AnianBrosig/powerPCB/PowerDistrobution2L/PowerDistrobution2L.step

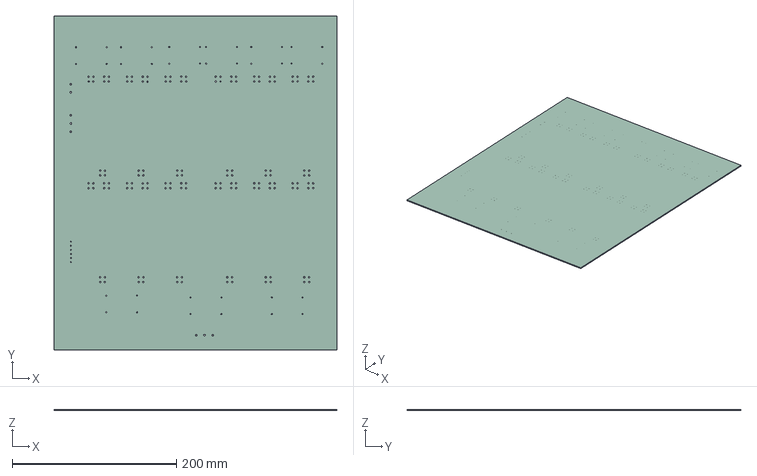
[picture p1: CAD file, 2025-11-11]
PowerDistrobution2L/PowerDistrobution2L.step
345.0 x 407.0 x 1.51 mm
