AnianBrosig/powerPCB/PowerDistribution3L/PowerDistrobution3L.kicad_pcb

## KiCad design PowerDistribution3L/PowerDistrobution3L.kicad_pcb (2025-11-13)

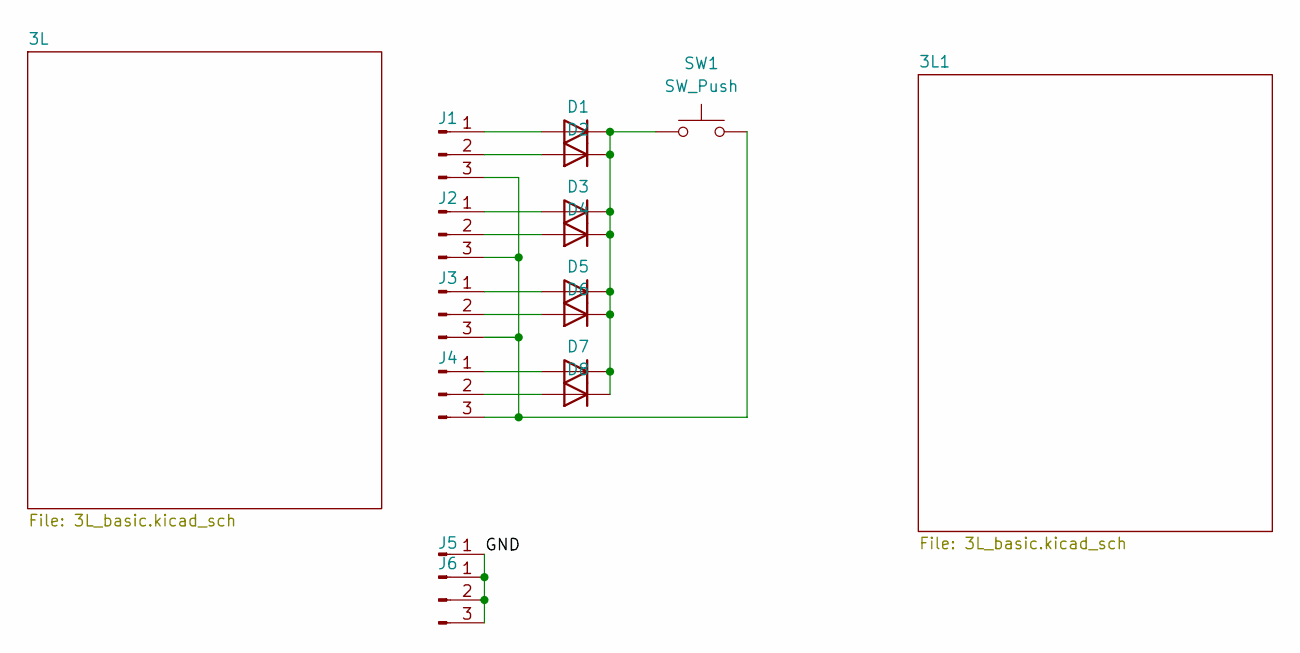
[picture p2: schematic PowerDistrobution3L.kicad_sch]

Parts:
D1, D2, D3, D4, D5, D6, D7, D8: 1N914; D_DO-35_SOD27_P7.62mm_Horizontal
J1, J3, J4, J6: Conn_01x03_Pin; PinHeader_1x03_P2.54mm_Vertical
J2: Connector_PinHeader_1.00mm:PinHeader_1x03_P1.00mm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; PinHeader_1x03_P2.54mm_Vertical
J5: Conn_01x01_Pin; Wuerth_REDCUBE-THR_WP-THRSH_74651175_THR
SW1: SW_Push; SW_PUSH_6mm

Connections:
/GND: J5.1, J6.1, J6.2, J6.3
unnamed: D1.2 (A), J1.1
unnamed: D1.1 (K), D2.1 (K), D3.1 (K), D4.1 (K), D5.1 (K), D6.1 (K), D7.1 (K), D8.1 (K), SW1.1
unnamed: D2.2 (A), J1.2
unnamed: D3.2 (A), J2.1
unnamed: D4.2 (A), J2.2
unnamed: D5.2 (A), J3.1
unnamed: D6.2 (A), J3.2
unnamed: D7.2 (A), J4.1
unnamed: D8.2 (A), J4.2
unnamed: J1.3, J2.3, J3.3, J4.3, SW1.2

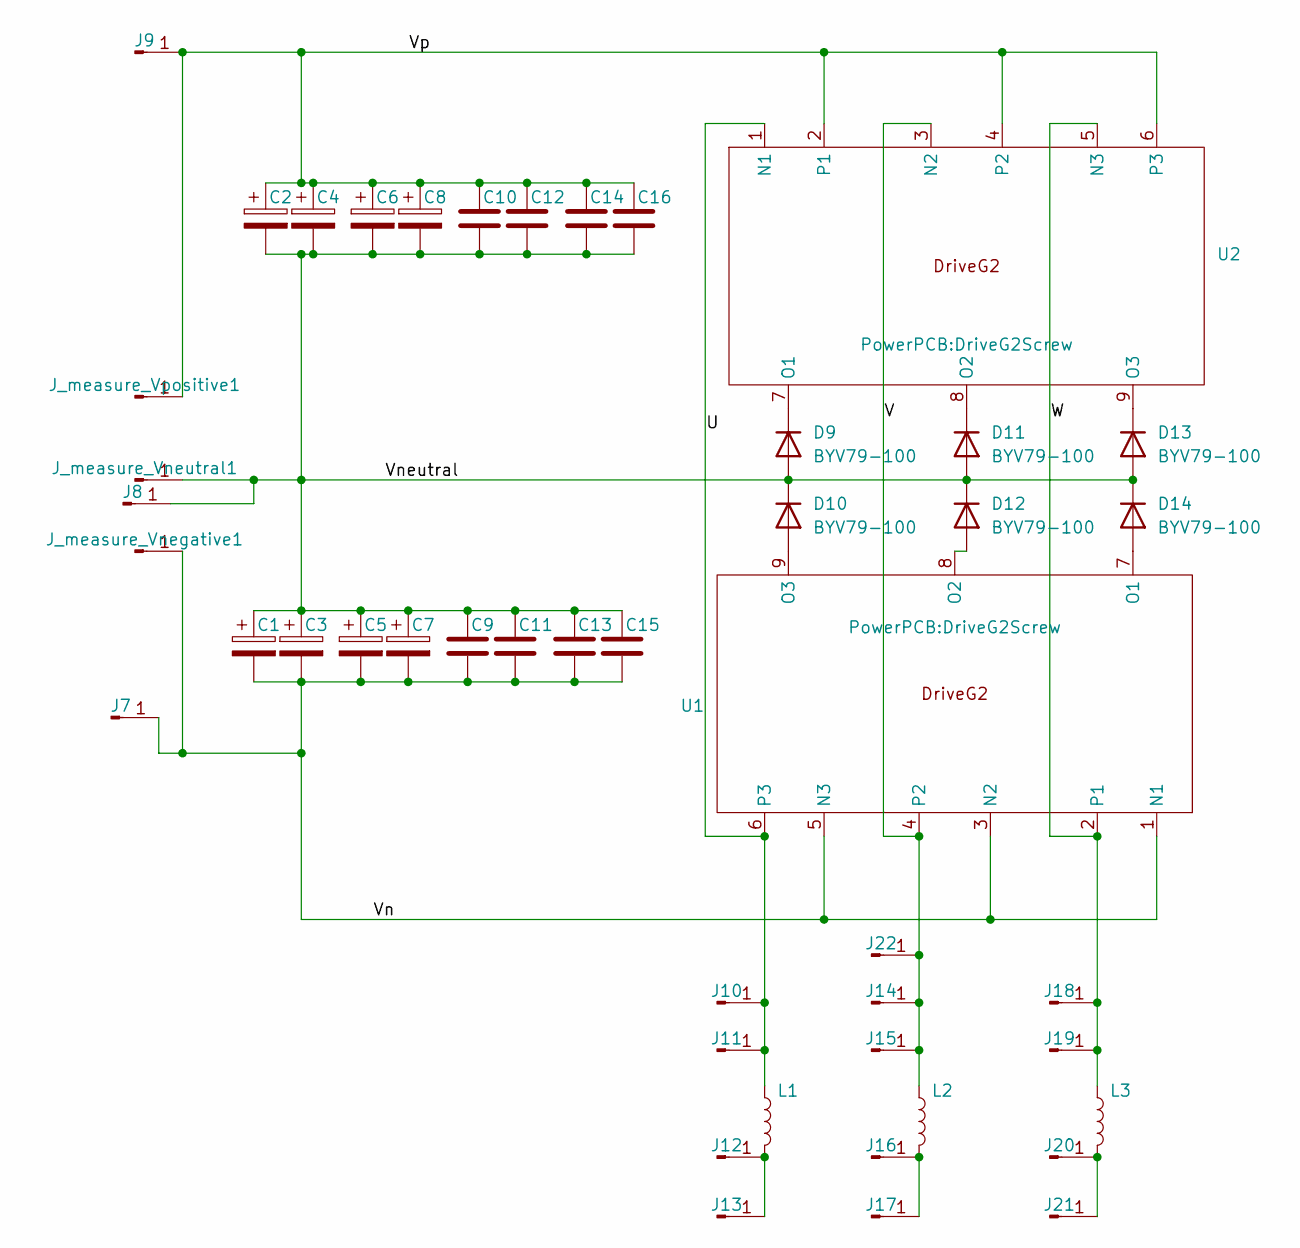
[picture p3: schematic 3L_basic.kicad_sch]

Parts:
C1, C2, C5, C6: C_Polarized; CP_Radial_D25.0mm_P10.00mm_SnapIn
C3, C4, C7, C8: C_Polarized; C_Wurth_WCAP-FTDB-L42W35H50
C9, C10, C11, C12, C13, C14, C15, C16: C; C_2220_5750Metric_Pad1.97x5.40mm_HandSolder
D9, D10, D11, D12, D13, D14: BYV79-100; TO-247-2_Vertical
J7, J8, J9, J10, J13, J14, J17, J18, J21, J22: Conn_01x01_Pin; Wuerth_REDCUBE-THR_WP-THRSH_74651175_THR
J11, J12, J15, J16, J19, J20: Conn_01x01_Pin; PinHeader_1x01_P1.00mm_Vertical
J_measure_Vnegative1: Conn_01x01_Pin; PinHeader_1x01_P1.00mm_Vertical
J_measure_Vneutral1: Conn_01x01_Pin; PinHeader_1x01_P1.00mm_Vertical
J_measure_Vpositive1: Conn_01x01_Pin; PinHeader_1x01_P1.00mm_Vertical
L1, L2, L3: L; Inductor
U1, U2: DriveG2Screw

Connections:
/3L/U: J10.1, J11.1, L1.1, U1.6 (P3), U2.1 (N1)
/3L/V: J14.1, J15.1, J22.1, L2.1, U1.4 (P2), U2.3 (N2)
/3L/Vn: C1.2, C3.2, C5.2, C7.2, C9.2, C11.2, C13.2, C15.2, J7.1, J_measure_Vnegative1.1, U1.1 (N1), U1.3 (N2), U1.5 (N3)
/3L/Vneutral: C1.1, C2.2, C3.1, C4.2, C5.1, C6.2, C7.1, C8.2, C9.1, C10.2, C11.1, C12.2, C13.1, C14.2, C15.1, C16.2, D9.2 (A), D10.1 (K), D11.2 (A), D12.1 (K), D13.2 (A), D14.1 (K), J8.1, J_measure_Vneutral1.1
/3L/Vp: C2.1, C4.1, C6.1, C8.1, C10.1, C12.1, C14.1, C16.1, J9.1, J_measure_Vpositive1.1, U2.2 (P1), U2.4 (P2), U2.6 (P3)
/3L/W: J18.1, J19.1, L3.1, U1.2 (P1), U2.5 (N3)
unnamed: D9.1 (K), U2.7 (O1)
unnamed: D10.2 (A), U1.9 (O3)
unnamed: D11.1 (K), U2.8 (O2)
unnamed: D12.2 (A), U1.8 (O2)
unnamed: D13.1 (K), U2.9 (O3)
unnamed: D14.2 (A), U1.7 (O1)
unnamed: J12.1, J13.1, L1.2
unnamed: J16.1, J17.1, L2.2
unnamed: J20.1, J21.1, L3.2

Parts of its further copies:
C17, C18, C21, C22: C_Polarized; CP_Radial_D25.0mm_P10.00mm_SnapIn
C19, C20, C23, C24: C_Polarized; C_Wurth_WCAP-FTDB-L42W35H50
C25, C26, C27, C28, C29, C30, C31, C32: C; C_2220_5750Metric_Pad1.97x5.40mm_HandSolder
D15, D16, D17, D18, D19, D20: BYV79-100; TO-247-2_Vertical
J23, J24, J25, J26, J29, J30, J31, J34, J35, J38: Conn_01x01_Pin; Wuerth_REDCUBE-THR_WP-THRSH_74651175_THR
J27, J28, J32, J33, J36, J37: Conn_01x01_Pin; PinHeader_1x01_P1.00mm_Vertical
J_measure_Vnegative2: Conn_01x01_Pin; PinHeader_1x01_P1.00mm_Vertical
J_measure_Vneutral2: Conn_01x01_Pin; PinHeader_1x01_P1.00mm_Vertical
J_measure_Vpositive2: Conn_01x01_Pin; PinHeader_1x01_P1.00mm_Vertical
L4, L5, L6: L; Inductor
U3, U4: DriveG2Screw

Connections of its further copies:
/3L1/U: J26.1, J27.1, L4.1, U3.6 (P3), U4.1 (N1)
/3L1/V: J30.1, J31.1, J32.1, L5.1, U3.4 (P2), U4.3 (N2)
/3L1/Vn: C17.2, C19.2, C21.2, C23.2, C25.2, C27.2, C29.2, C31.2, J23.1, J_measure_Vnegative2.1, U3.1 (N1), U3.3 (N2), U3.5 (N3)
/3L1/Vneutral: C17.1, C18.2, C19.1, C20.2, C21.1, C22.2, C23.1, C24.2, C25.1, C26.2, C27.1, C28.2, C29.1, C30.2, C31.1, C32.2, D15.2 (A), D16.1 (K), D17.2 (A), D18.1 (K), D19.2 (A), D20.1 (K), J24.1, J_measure_Vneutral2.1
/3L1/Vp: C18.1, C20.1, C22.1, C24.1, C26.1, C28.1, C30.1, C32.1, J25.1, J_measure_Vpositive2.1, U4.2 (P1), U4.4 (P2), U4.6 (P3)
/3L1/W: J35.1, J36.1, L6.1, U3.2 (P1), U4.5 (N3)
unnamed: D15.1 (K), U4.7 (O1)
unnamed: D16.2 (A), U3.9 (O3)
unnamed: D17.1 (K), U4.8 (O2)
unnamed: D18.2 (A), U3.8 (O2)
unnamed: D19.1 (K), U4.9 (O3)
unnamed: D20.2 (A), U3.7 (O1)
unnamed: J28.1, J29.1, L4.2
unnamed: J33.1, J34.1, L5.2
unnamed: J37.1, J38.1, L6.2

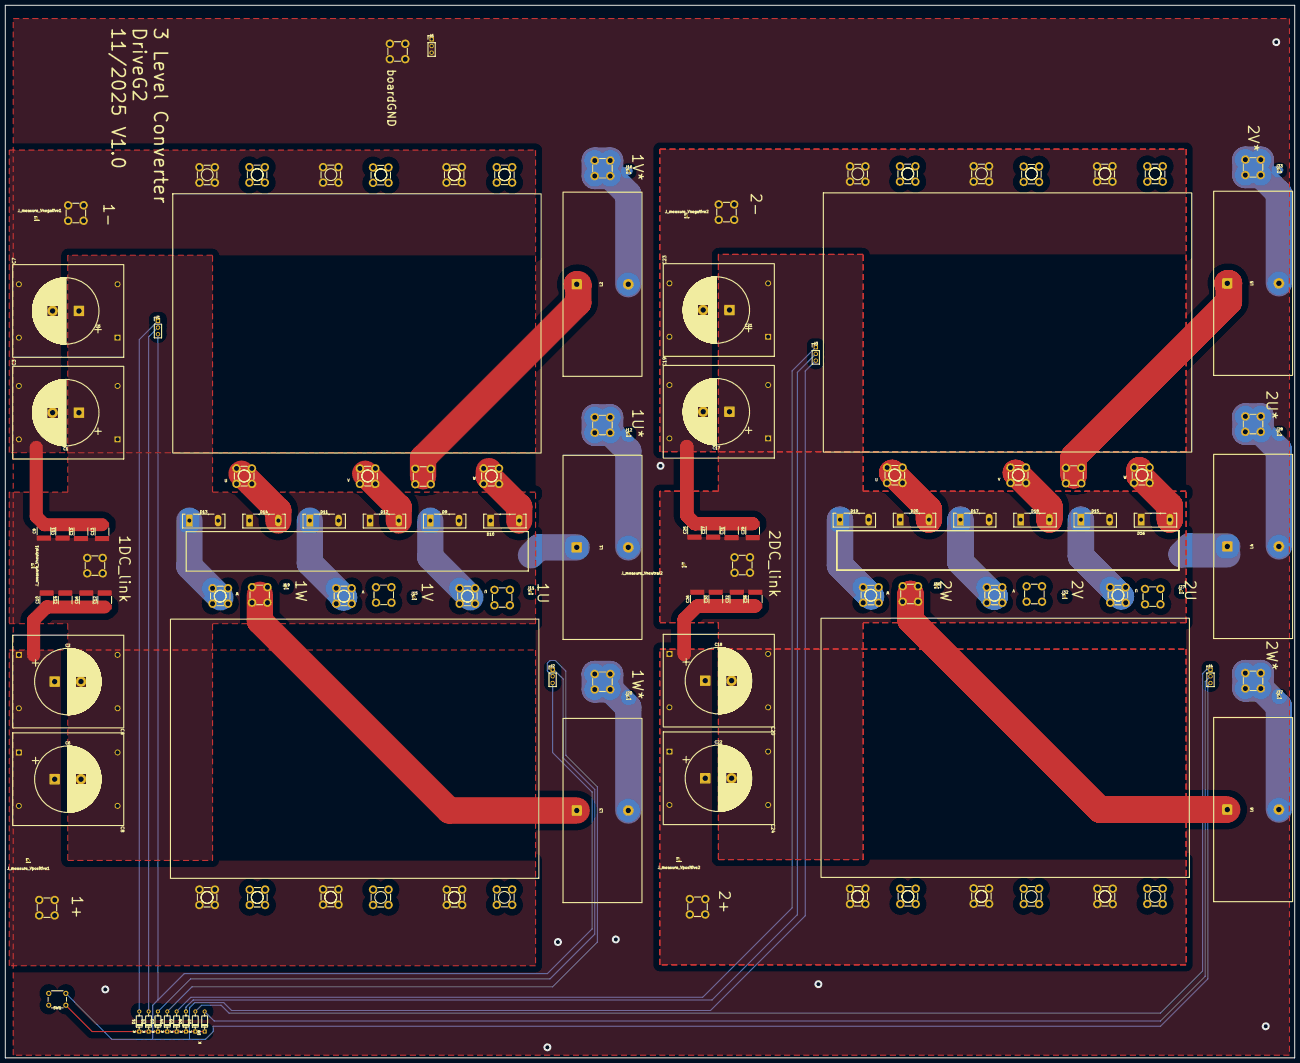
[picture p4: board PowerDistrobution3L.kicad_pcb from above]

Board: 2 copper layers, 490.0 x 400.0 mm, 107 parts (0 on the bottom side), 41 nets.
