AnianBrosig/powerPCB/PowerDistribution5L/PowerDistribution5L.kicad_pcb

## KiCad design PowerDistribution5L/PowerDistribution5L.kicad_pcb (2025-11-13)

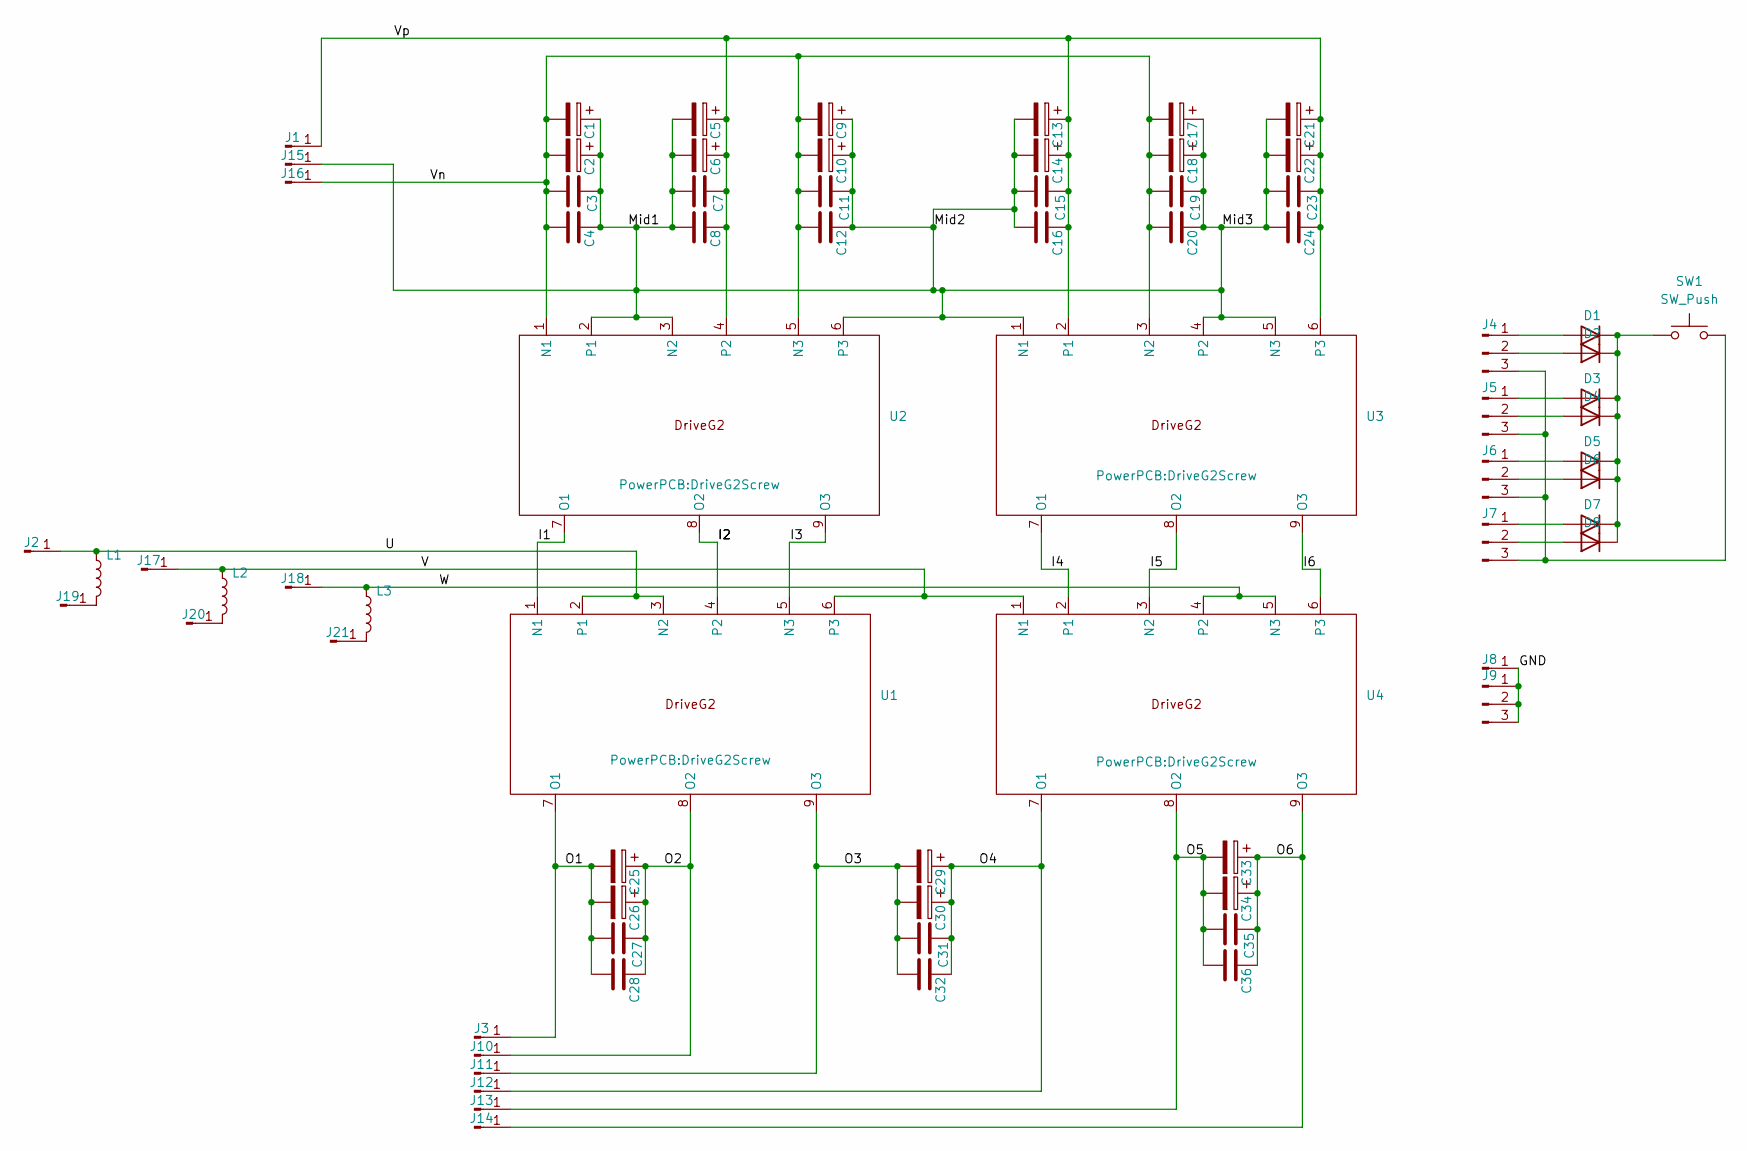
[picture p5: schematic PowerDistribution5L.kicad_sch]

Parts:
C1, C5, C9, C13, C17, C21, C25, C29, C33: C_Polarized; CP_Radial_D25.0mm_P10.00mm_SnapIn
C2, C6, C10, C14, C18, C22, C26, C30, C34: C_Polarized; C_Wurth_WCAP-FTDB-L42W35H50
C3, C4, C7, C8, C11, C12, C15, C16, C19, C20, C23, C24, C27, C28, C31, C32, C35, C36: C; C_2220_5750Metric_Pad1.97x5.40mm_HandSolder
D1, D2, D3, D4, D5, D6, D7, D8: 1N914; D_DO-35_SOD27_P7.62mm_Horizontal
J1, J2, J3, J8, J10, J11, J12, J13, J14, J15, J16, J17, J18, J19, J20, J21: Conn_01x01_Pin; Wuerth_REDCUBE-THR_WP-THRSH_74651175_THR
J4, J6, J7, J9: Conn_01x03_Pin; PinHeader_1x03_P2.54mm_Vertical
J5: Connector_PinHeader_1.00mm:PinHeader_1x03_P1.00mm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; PinHeader_1x03_P2.54mm_Vertical
L1, L2, L3: L; Inductor
SW1: SW_Push; SW_PUSH_6mm
U1, U2, U3, U4: DriveG2Screw

Connections:
/GND: J8.1, J9.1, J9.2, J9.3
/I1: U1.1 (N1), U2.7 (O1)
/I2: U1.4 (P2), U2.8 (O2)
/I3: U1.5 (N3), U2.9 (O3)
/I4: U3.7 (O1), U4.2 (P1)
/I5: U3.8 (O2), U4.3 (N2)
/I6: U3.9 (O3), U4.6 (P3)
/Mid1: C1.1, C2.1, C3.1, C4.1, C5.2, C6.2, C7.2, C8.2, C9.1, C10.1, C11.1, C12.1, C13.2, C14.2, C15.2, C16.2, C17.1, C18.1, C19.1, C20.1, C21.2, C22.2, C23.2, C24.2, J15.1, U2.2 (P1), U2.3 (N2), U2.6 (P3), U3.1 (N1), U3.4 (P2), U3.5 (N3)
/O1: C25.2, C26.2, C27.2, C28.2, J3.1, U1.7 (O1)
/O2: C25.1, C26.1, C27.1, C28.1, J10.1, U1.8 (O2)
/O3: C29.2, C30.2, C31.2, C32.2, J11.1, U1.9 (O3)
/O4: C29.1, C30.1, C31.1, C32.1, J12.1, U4.7 (O1)
/O5: C33.2, C34.2, C35.2, C36.2, J13.1, U4.8 (O2)
/O6: C33.1, C34.1, C35.1, C36.1, J14.1, U4.9 (O3)
/U: J2.1, L1.1, U1.2 (P1), U1.3 (N2)
/V: J17.1, L2.1, U1.6 (P3), U4.1 (N1)
/Vn: C1.2, C2.2, C3.2, C4.2, C9.2, C10.2, C11.2, C12.2, C17.2, C18.2, C19.2, C20.2, J16.1, U2.1 (N1), U2.5 (N3), U3.3 (N2)
/Vp: C5.1, C6.1, C7.1, C8.1, C13.1, C14.1, C15.1, C16.1, C21.1, C22.1, C23.1, C24.1, J1.1, U2.4 (P2), U3.2 (P1), U3.6 (P3)
/W: J18.1, L3.1, U4.4 (P2), U4.5 (N3)
unnamed: D1.2 (A), J4.1
unnamed: D1.1 (K), D2.1 (K), D3.1 (K), D4.1 (K), D5.1 (K), D6.1 (K), D7.1 (K), D8.1 (K), SW1.1
unnamed: D2.2 (A), J4.2
unnamed: D3.2 (A), J5.1
unnamed: D4.2 (A), J5.2
unnamed: D5.2 (A), J6.1
unnamed: D6.2 (A), J6.2
unnamed: D7.2 (A), J7.1
unnamed: D8.2 (A), J7.2
unnamed: J4.3, J5.3, J6.3, J7.3, SW1.2
unnamed: J19.1, L1.2
unnamed: J20.1, L2.2
unnamed: J21.1, L3.2

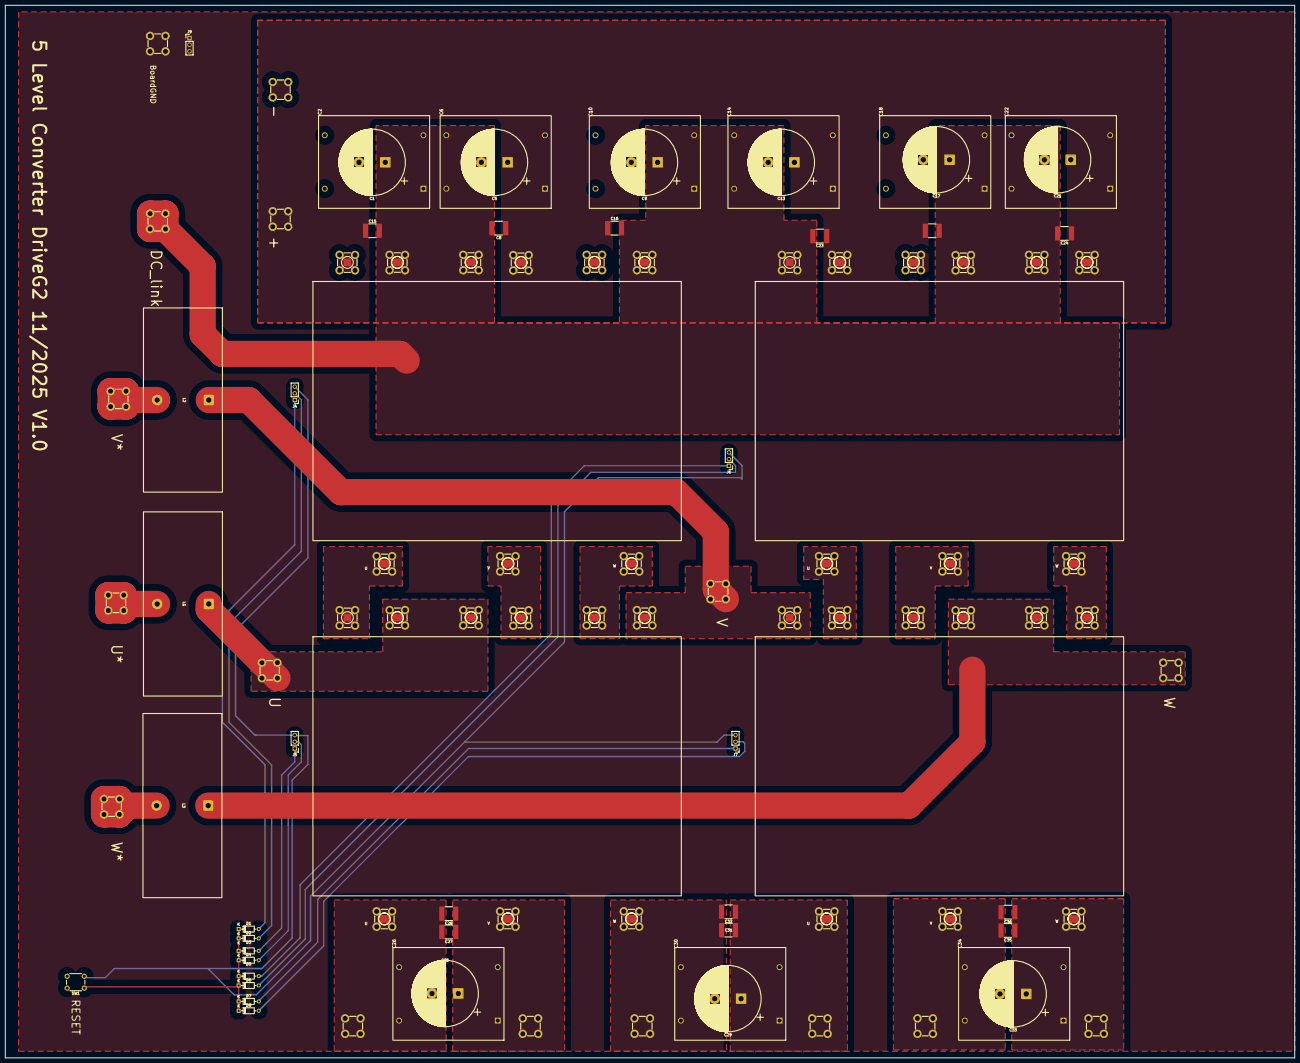
[picture p6: board PowerDistribution5L.kicad_pcb from above]

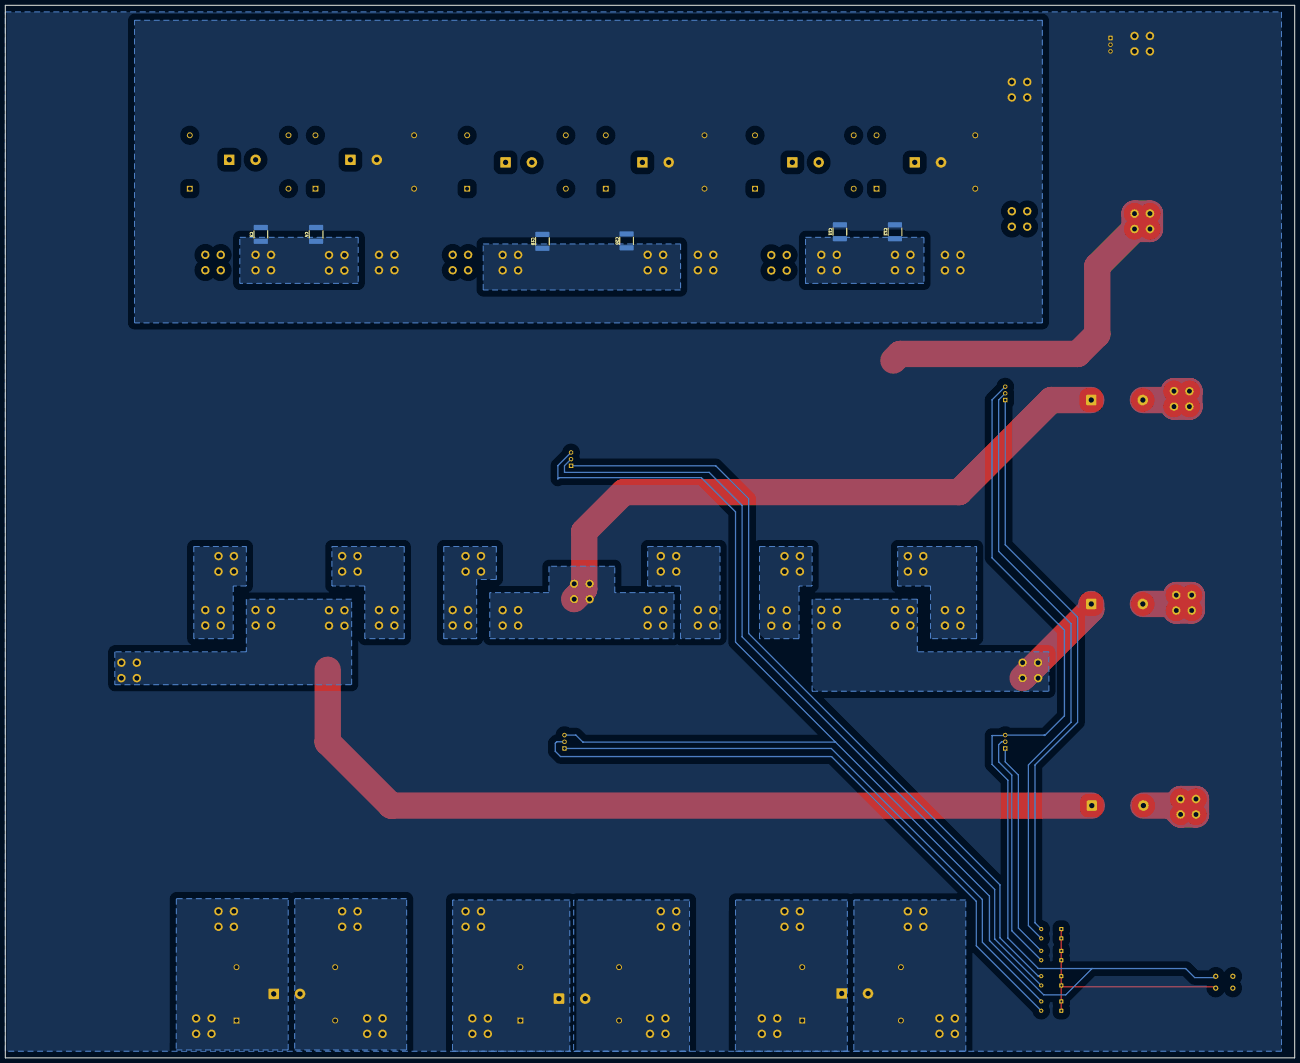
[picture p7: board PowerDistribution5L.kicad_pcb from below]

Board: 2 copper layers, 490.0 x 400.0 mm, 73 parts (6 on the bottom side), 32 nets.
