AnianBrosig/powerPCB/PowerDistrobution2L/PowerDistrobution2L.kicad_pcb

## KiCad design PowerDistrobution2L/PowerDistrobution2L.kicad_pcb (2025-11-11)

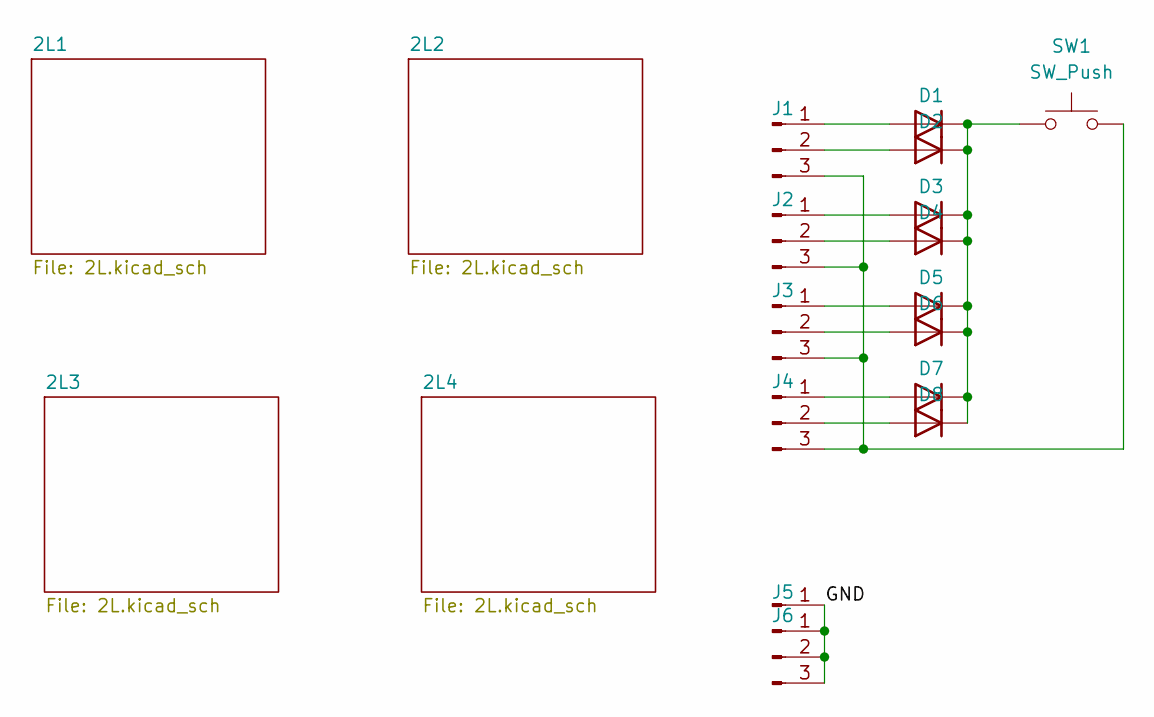
[picture p8: schematic PowerDistrobution2L.kicad_sch]

Parts:
D1, D2, D3, D4, D5, D6, D7, D8: 1N914; D_DO-35_SOD27_P7.62mm_Horizontal
J1, J3, J4, J6: Conn_01x03_Pin; PinHeader_1x03_P2.54mm_Vertical
J2: Connector_PinHeader_1.00mm:PinHeader_1x03_P1.00mm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; PinHeader_1x03_P2.54mm_Vertical
J5: Conn_01x01_Pin; Wuerth_REDCUBE-THR_WP-THRSH_74651175_THR
SW1: SW_Push; SW_PUSH_6mm

Connections:
/GND: J5.1, J6.1, J6.2, J6.3
unnamed: D1.2 (A), J1.1
unnamed: D1.1 (K), D2.1 (K), D3.1 (K), D4.1 (K), D5.1 (K), D6.1 (K), D7.1 (K), D8.1 (K), SW1.1
unnamed: D2.2 (A), J1.2
unnamed: D3.2 (A), J2.1
unnamed: D4.2 (A), J2.2
unnamed: D5.2 (A), J3.1
unnamed: D6.2 (A), J3.2
unnamed: D7.2 (A), J4.1
unnamed: D8.2 (A), J4.2
unnamed: J1.3, J2.3, J3.3, J4.3, SW1.2

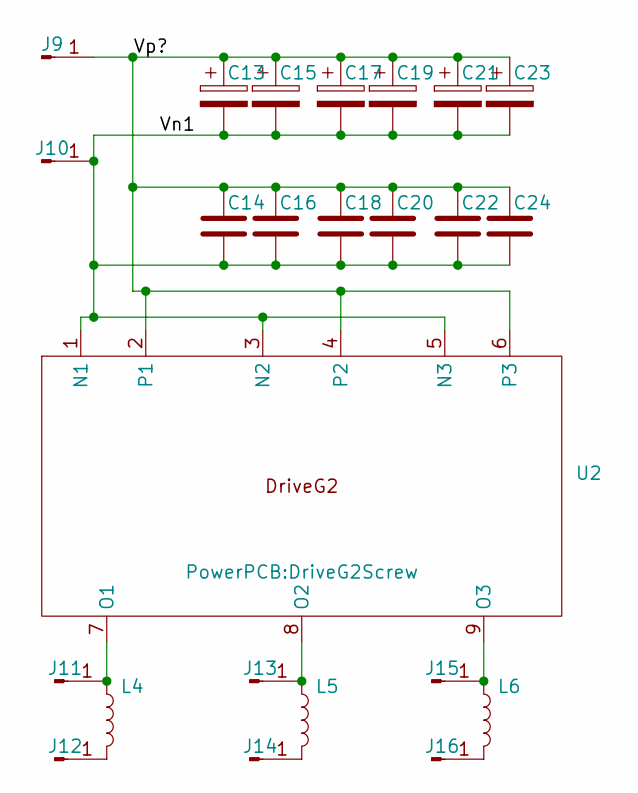
[picture p9: schematic 2L.kicad_sch]

Parts:
C13, C17, C21: C_Polarized; CP_Radial_D25.0mm_P10.00mm_SnapIn
C14, C16, C18, C20, C22, C24: C; C_2220_5750Metric_Pad1.97x5.40mm_HandSolder
C15, C19, C23: C_Polarized; C_Wurth_WCAP-FTDB-L42W35H50
J9, J10, J11, J12, J13, J14, J15, J16: Conn_01x01_Pin; Wuerth_REDCUBE-THR_WP-THRSH_74651175_THR
L4, L5, L6: L; Inductor
U2: DriveG2Screw

Connections:
/2L1/Vn1: C13.2, C14.2, C15.2, C16.2, C17.2, C18.2, C19.2, C20.2, C21.2, C22.2, C23.2, C24.2, J10.1, U2.1 (N1), U2.3 (N2), U2.5 (N3)
/2L1/Vp?: C13.1, C14.1, C15.1, C16.1, C17.1, C18.1, C19.1, C20.1, C21.1, C22.1, C23.1, C24.1, J9.1, U2.2 (P1), U2.4 (P2), U2.6 (P3)
unnamed: J11.1, L4.1, U2.7 (O1)
unnamed: J12.1, L4.2
unnamed: J13.1, L5.1, U2.8 (O2)
unnamed: J14.1, L5.2
unnamed: J15.1, L6.1, U2.9 (O3)
unnamed: J16.1, L6.2

Parts of its further copies:
C25, C29, C33, C37, C41, C45, C49, C53, C57: C_Polarized; CP_Radial_D25.0mm_P10.00mm_SnapIn
C26, C28, C30, C32, C34, C36, C38, C40, C42, C44, C46, C48, C50, C52, C54, C56, C58, C60: C; C_2220_5750Metric_Pad1.97x5.40mm_HandSolder
C27, C31, C35, C39, C43, C47, C51, C55, C59: C_Polarized; C_Wurth_WCAP-FTDB-L42W35H50
J17, J18, J19, J20, J21, J22, J23, J24, J25, J26, J27, J29, J31, J33, J34, J35, J37, J39: Conn_01x01_Pin; Wuerth_REDCUBE-THR_WP-THRSH_74651175_THR
L7, L8, L9: L; Inductor
U3, U4, U5: DriveG2Screw

Connections of its further copies:
/2L2/Vn1: C25.2, C26.2, C27.2, C28.2, C29.2, C30.2, C31.2, C32.2, C33.2, C34.2, C35.2, C36.2, J18.1, U3.1 (N1), U3.3 (N2), U3.5 (N3)
/2L2/Vp?: C25.1, C26.1, C27.1, C28.1, C29.1, C30.1, C31.1, C32.1, C33.1, C34.1, C35.1, C36.1, J17.1, U3.2 (P1), U3.4 (P2), U3.6 (P3)
/2L3/Vn1: C37.2, C38.2, C39.2, C40.2, C41.2, C42.2, C43.2, C44.2, C45.2, C46.2, C47.2, C48.2, J26.1, U4.1 (N1), U4.3 (N2), U4.5 (N3)
/2L3/Vp?: C37.1, C38.1, C39.1, C40.1, C41.1, C42.1, C43.1, C44.1, C45.1, C46.1, C47.1, C48.1, J25.1, U4.2 (P1), U4.4 (P2), U4.6 (P3)
/2L4/Vn1: C49.2, C50.2, C51.2, C52.2, C53.2, C54.2, C55.2, C56.2, C57.2, C58.2, C59.2, C60.2, J34.1, U5.1 (N1), U5.3 (N2), U5.5 (N3)
/2L4/Vp?: C49.1, C50.1, C51.1, C52.1, C53.1, C54.1, C55.1, C56.1, C57.1, C58.1, C59.1, C60.1, J33.1, U5.2 (P1), U5.4 (P2), U5.6 (P3)
unnamed: J19.1, L7.1, U3.7 (O1)
unnamed: J20.1, L7.2
unnamed: J21.1, L8.1, U3.8 (O2)
unnamed: J22.1, L8.2
unnamed: J23.1, L9.1, U3.9 (O3)
unnamed: J24.1, L9.2
unnamed: J27.1, U4.7 (O1)
unnamed: J29.1, U4.8 (O2)
unnamed: J31.1, U4.9 (O3)
unnamed: J35.1, U5.7 (O1)
unnamed: J37.1, U5.8 (O2)
unnamed: J39.1, U5.9 (O3)

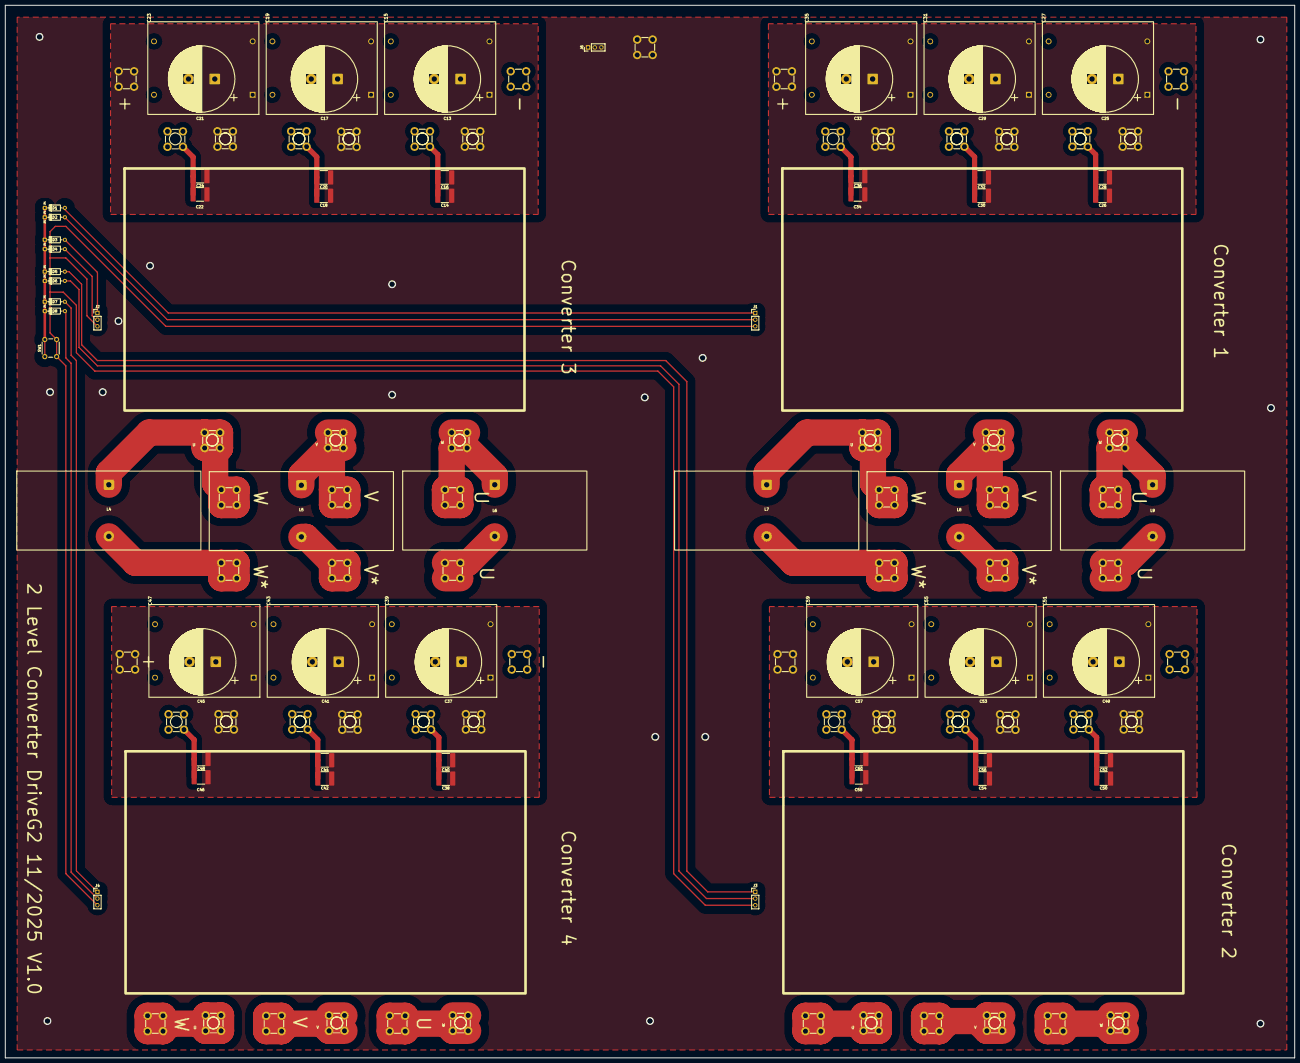
[picture p10: board PowerDistrobution2L.kicad_pcb from above]

Board: 2 copper layers, 490.0 x 400.0 mm, 99 parts (0 on the bottom side), 37 nets.
