AnianBrosig/powerPCB/(commit log)

2025-11-11 2L Initial
    [2L.kicad_sch, PowerDistrobution2L.kicad_pcb, PowerDistrobution2L.kicad_sch, PowerDistrobution2L.step]
2025-11-13 add 3 Level and 5 Level
    [3L_basic.kicad_sch, PowerDistribution5L.kicad_pcb, PowerDistribution5L.kicad_sch, PowerDistrobution3L.kicad_pcb, PowerDistrobution3L.kicad_sch]
